xiaoyuehai/ExSpike/rtl/axi_ddr/input_uart_r.v

// -----------------------------------------------------------------------------
// Copyright (c) 2025-2026 All rights reserved
// -----------------------------------------------------------------------------
// Author : Yuehai Chen yuehai.chen@rug.nl
// File   : axi_ddr/input_uart_r.v
// Create : 2025-12-01 10:00:00
// Revise : 2025-12-01 10:00:00
// Editor : vscode, tab size (4)
// Description: UART receiver for host input data.
// -----------------------------------------------------------------------------

`timescale 1ns / 1ps
//////////////////////////////////////////////////////////////////////////////////
// Company: 
// Engineer: 
// 
// Create Date: 2021/12/08 21:52:41
// Design Name: 
// Module Name: Uart_Rx
// Project Name: 
// Target Devices: 
// Tool Versions: 
// Description: 
// 
// Dependencies: 
// 
// Revision:
// Revision 0.01 - File Created
// Additional Comments:
// 
//////////////////////////////////////////////////////////////////////////////////


module input_uart_r(
	input				sclk,         // system clock input  
	input				s_rst_n,         // system reset signal
	
	input				rx,         // RS232 UART receive signal
	
	output reg	[7:0]	rx_data,         // received data
	output reg			po_flag 					 // transfer complete flag
 
);
 
	// synchronize and buffer input data
	reg			rx_r1;
	reg			rx_r2;
	reg			rx_r3;
	
	reg			rx_flag;             // data transfer flag
	reg	[12:0]	baud_cnt;
	reg			bit_flag;
	reg	[3:0]	bit_cnt;
	
//----------------- parameter definitions -----------------------------
//localparam BAUD_END			=			13'd5207			;
localparam BAUD_END			=			13'd1736;//1736;// 434;
localparam BIT_END			=			4'd8;
 
wire rx_negetive			= 			~rx_r2&rx_r3;  // capture falling edge of rx to detect start of transmission
 
always @(posedge sclk or negedge s_rst_n)
	if(!s_rst_n)begin
		rx_r1 <= 1'b1;
		rx_r2 <= 1'b1;
		rx_r3 <= 1'b1;
		end
	else begin
		rx_r1 <= rx;
		rx_r2 <= rx_r1;
		rx_r3 <= rx_r2;
	end
		
//rx_flag
always @(posedge sclk or negedge s_rst_n)
	if(!s_rst_n)
		rx_flag			<=				1'b0;
	else if(rx_negetive==1'b1)
		rx_flag			<=				1'b1;
	else if((baud_cnt==BAUD_END)&&(bit_cnt==4'd0))
		rx_flag			<= 			1'b0;
	else
		rx_flag 			<= 			rx_flag;
		
//baud_cnt
always @(posedge sclk or negedge s_rst_n)
	if(!s_rst_n)
		baud_cnt			<=				'd0;
	else if(baud_cnt==BAUD_END)
		baud_cnt			<=				'd0;
	else if(rx_flag==1'b1)
		baud_cnt			<= 			baud_cnt + 1'b1;
	else
		baud_cnt <= baud_cnt;
		
//bit_flag
always @(posedge sclk or negedge s_rst_n)
	if(!s_rst_n)
		bit_flag <= 1'b0;
	else if(baud_cnt==(BAUD_END/2))
		bit_flag <= 1'b1;
	else
		bit_flag <= 1'b0;
 
//bit_cnt
always @(posedge sclk or negedge s_rst_n)
	if(!s_rst_n)
		bit_cnt <= 'd0;
	else if((bit_cnt==BIT_END)&&(bit_flag==1'b1))
		bit_cnt <= 'd0;
	else if(bit_flag)
		bit_cnt <= bit_cnt + 1'b1;
	else 
		bit_cnt <= bit_cnt;
		
//rx_data
always @(posedge sclk or negedge s_rst_n)
	if(!s_rst_n)
		rx_data <= 'd0;
	else if((bit_flag==1'b1)&&(bit_cnt>=1'b1))
		rx_data <= {rx_r2,rx_data[7:1]};
	else
		rx_data <= rx_data;
		
//po_flag
always @(posedge sclk or negedge s_rst_n)
	if(!s_rst_n)
		po_flag <= 1'b0;
	else if((bit_cnt==BIT_END)&&(bit_flag==1'b1))
		po_flag <= 1'b1;
	else
		po_flag <= 1'b0;
 
endmodule
